genenadela/CET4811_MobileRobotArm/parts/readme.md

Parts were created in Fusion360.
Printed using Prusa Mk3, using PLA+.

Gripper and Arm design taken from howtomechatronics.com.
