genenadela/CET4811_MobileRobotArm/parts/gear1.STL

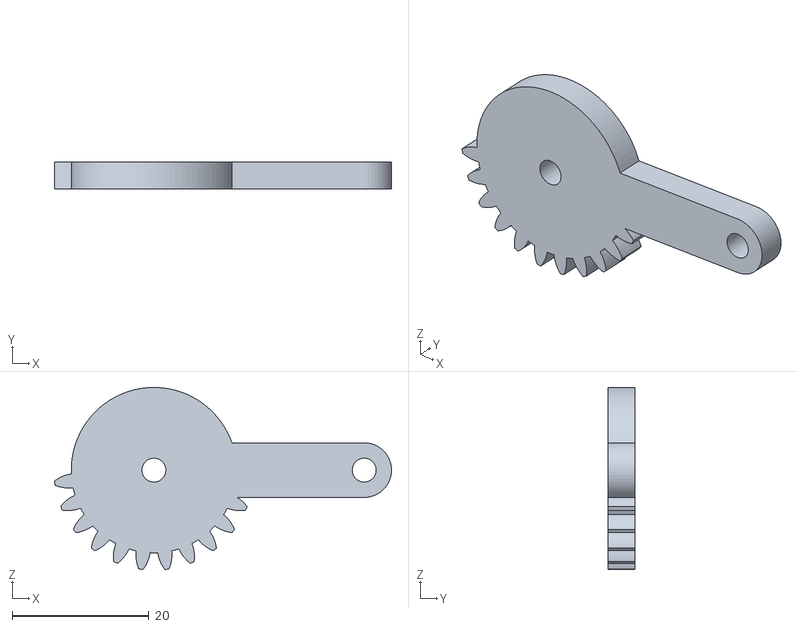
[picture p17: CAD file, 2020-10-12]
parts/gear1.STL
49.3 x 4.00 x 26.6
