genenadela/CET4811_MobileRobotArm/parts/studentmadeparts/autonomousrobot/axle1.stl

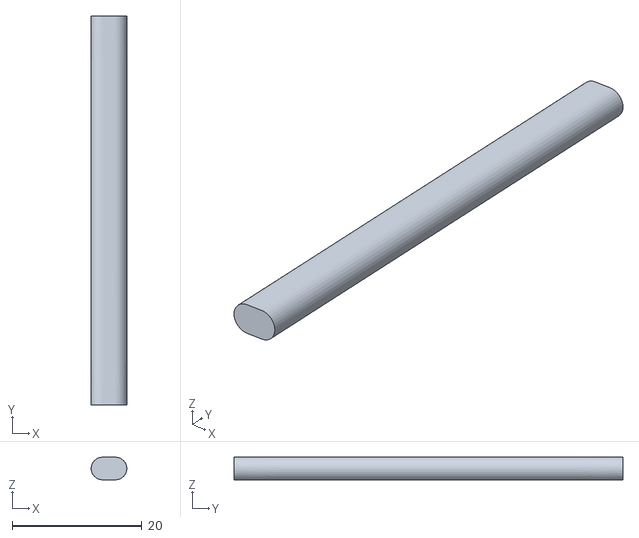
[picture p18: CAD file, 2020-10-12]
parts/studentmadeparts/autonomousrobot/axle1.stl
5.50 x 60.0 x 3.50
