genenadela/CET4811_MobileRobotArm/parts/studentmadeparts/frontcoverplate2.stl

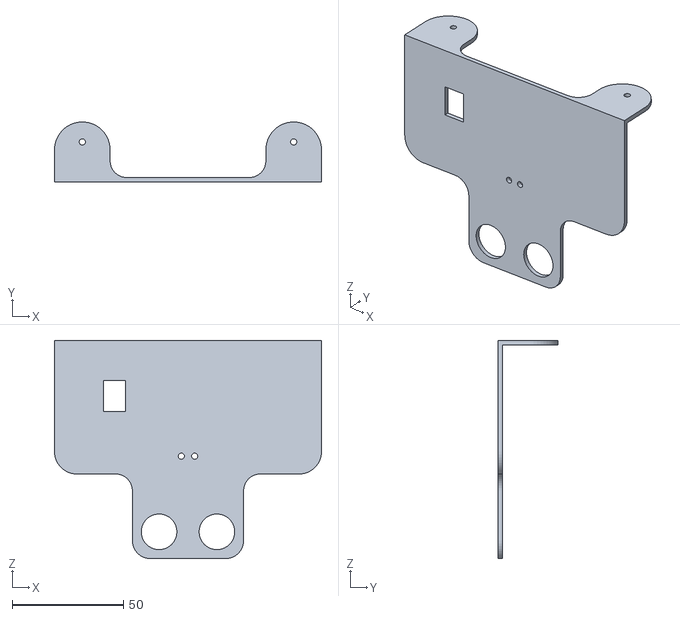
[picture p19: CAD file, 2020-10-12]
parts/studentmadeparts/frontcoverplate2.stl
120.0 x 27.0 x 98.0
