genenadela/CET4811_MobileRobotArm/parts/Arm 01.STL

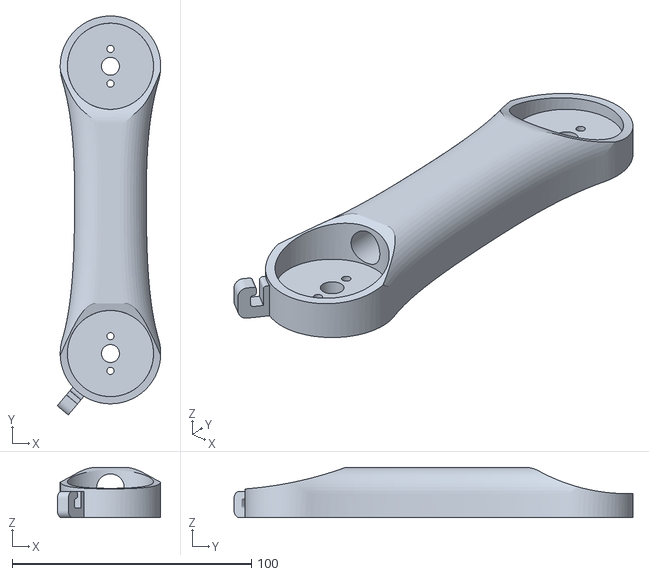
[picture p20: CAD file, 2020-10-12]
parts/Arm 01.STL
43.2 x 166.7 x 21.0
