genenadela/CET4811_MobileRobotArm/parts/studentmadeparts/WheelCoupler_DCMotorAdapter v3.stl

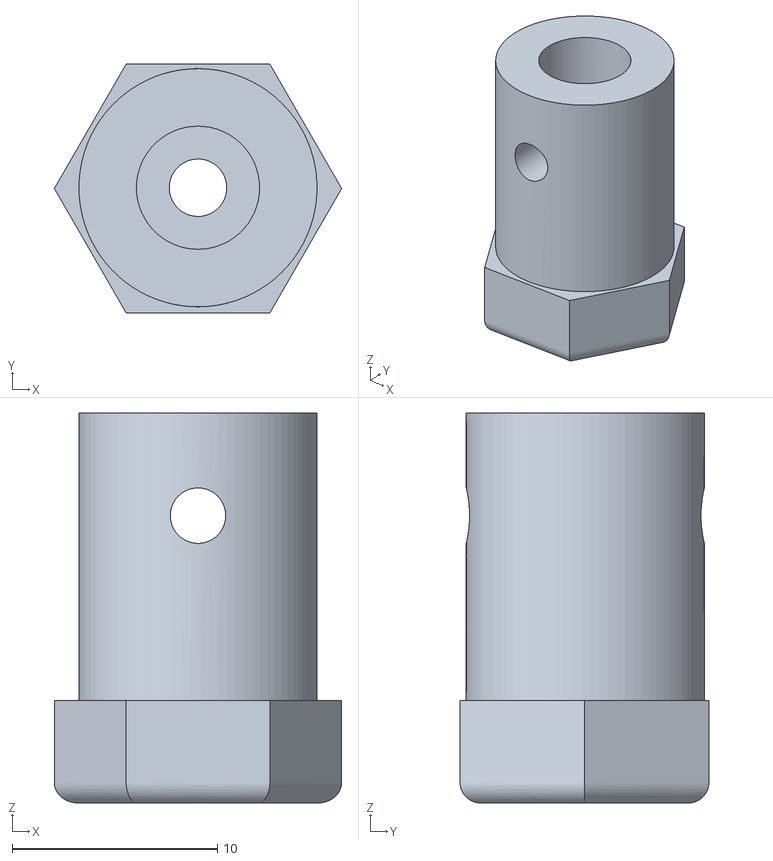
[picture p21: CAD file, 2020-10-12]
parts/studentmadeparts/WheelCoupler_DCMotorAdapter v3.stl
14.0 x 12.1 x 19.0
