genenadela/CET4811_MobileRobotArm/parts/studentmadeparts/wheelcoupler_dcmotor_v5.stl

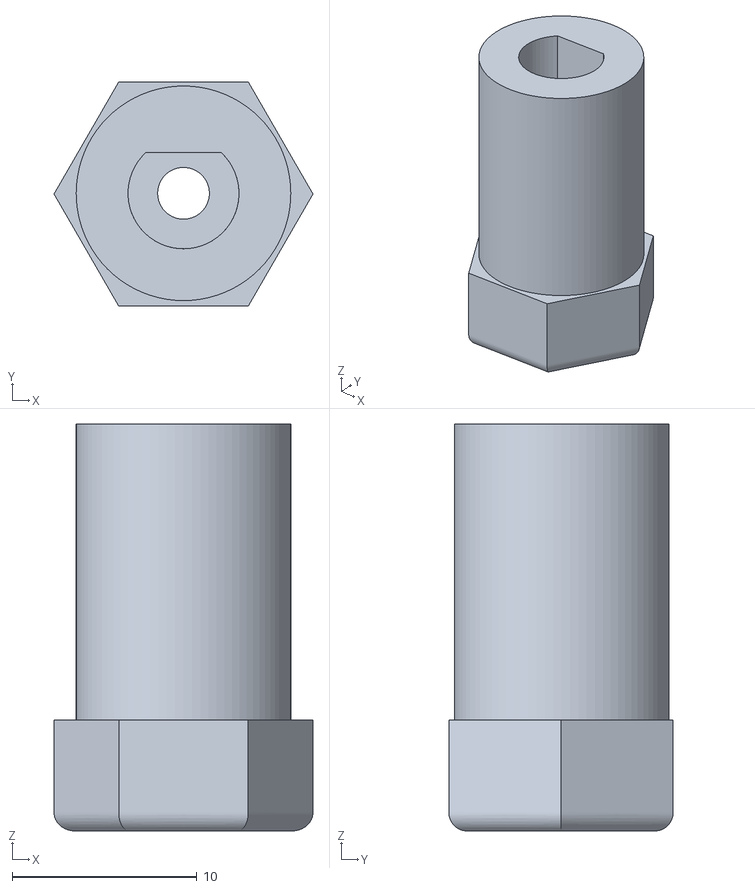
[picture p22: CAD file, 2020-10-12]
parts/studentmadeparts/wheelcoupler_dcmotor_v5.stl
14.0 x 12.1 x 22.0
