genenadela/CET4811_MobileRobotArm/parts/grip link 1.STL

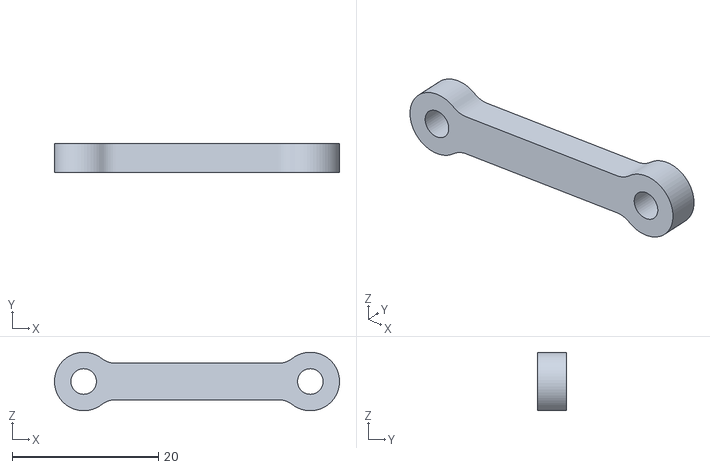
[picture p23: CAD file, 2020-10-12]
parts/grip link 1.STL
39.0 x 4.00 x 8.00
