genenadela/CET4811_MobileRobotArm/parts/studentmadeparts/BasePlatform v2.stl

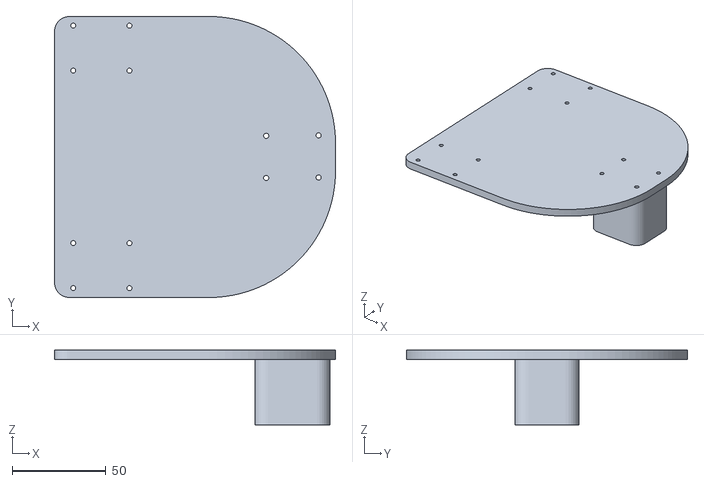
[picture p24: CAD file, 2020-10-12]
parts/studentmadeparts/BasePlatform v2.stl
150.0 x 150.0 x 40.0
