genenadela/CET4811_MobileRobotArm/parts/Gripper base.STL

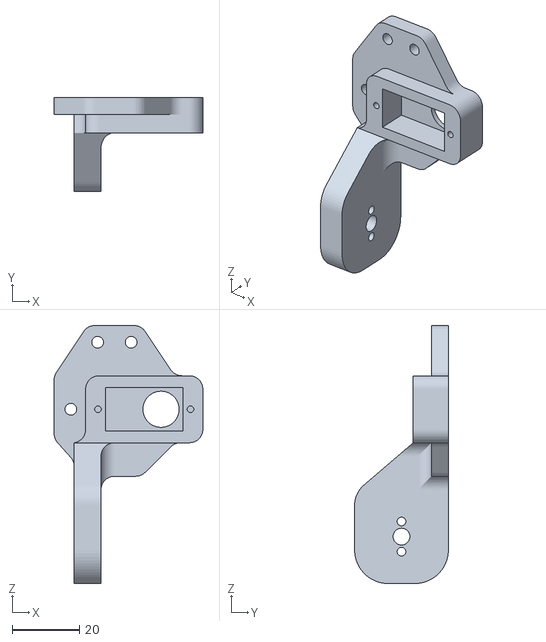
[picture p25: CAD file, 2020-10-12]
parts/Gripper base.STL
44.4 x 28.0 x 77.0
