genenadela/CET4811_MobileRobotArm/parts/studentmadeparts/upperplatform2.stl

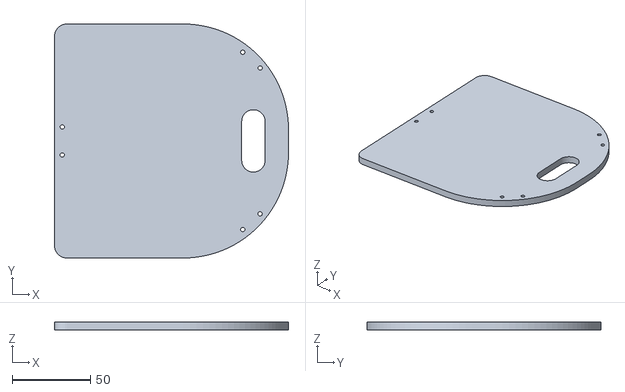
[picture p26: CAD file, 2020-10-12]
parts/studentmadeparts/upperplatform2.stl
150.0 x 150.0 x 5.00
