genenadela/CET4811_MobileRobotArm/parts/Arm 02 v3.STL

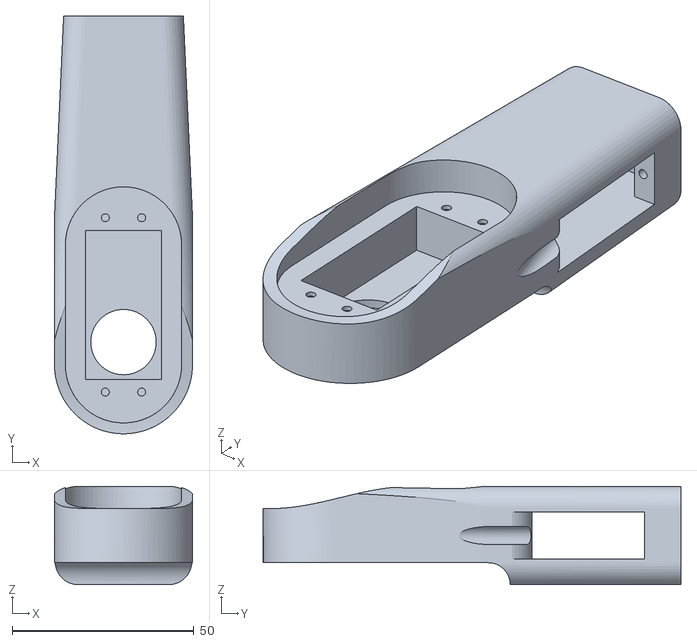
[picture p27: CAD file, 2020-10-12]
parts/Arm 02 v3.STL
38.0 x 115.0 x 27.0
