genenadela/CET4811_MobileRobotArm/parts/set2.3mf

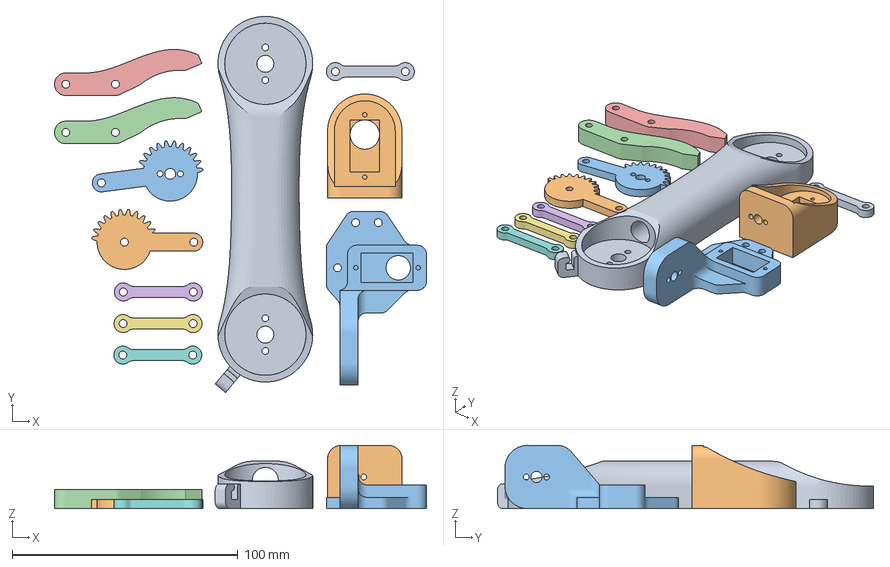
[picture p28: CAD file, 2020-10-12]
parts/set2.3mf
164.8 x 166.7 x 28.0 mm
Arm 01.STL
Arm 03.STL
Gripper base.STL
Gripper 1.STL
grip link 1.STL
gear1.STL
gear2.STL
