genenadela/CET4811_MobileRobotArm/parts/studentmadeparts/batteryholder.stl

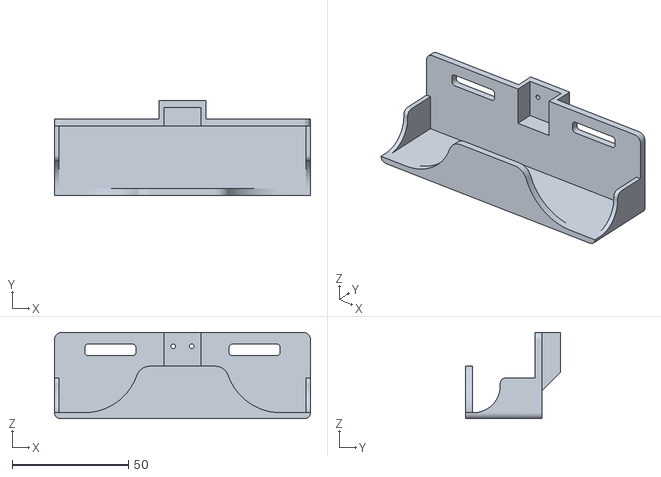
[picture p29: CAD file, 2020-10-12]
parts/studentmadeparts/batteryholder.stl
110.0 x 41.0 x 37.0
