genenadela/CET4811_MobileRobotArm/parts/Waist.STL

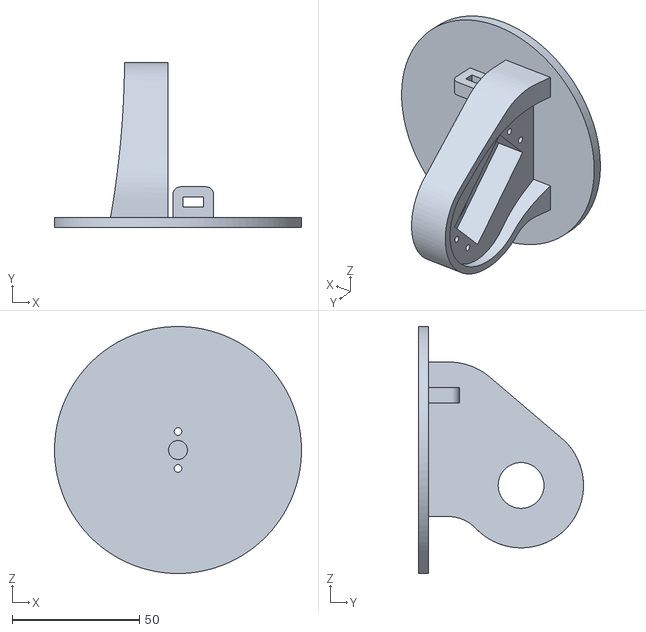
[picture p30: CAD file, 2020-10-12]
parts/Waist.STL
97.0 x 64.8 x 97.0
