genenadela/CET4811_MobileRobotArm/parts/Arm 03.STL

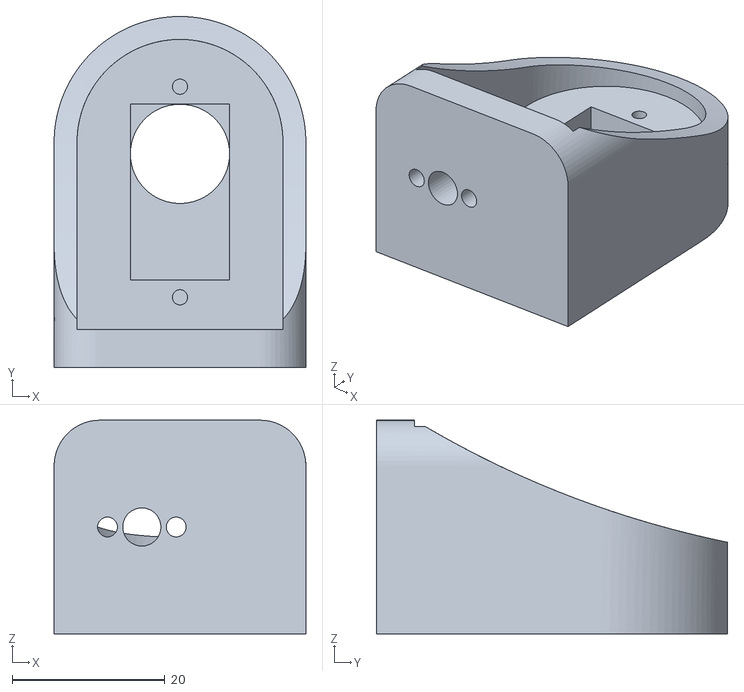
[picture p31: CAD file, 2020-10-12]
parts/Arm 03.STL
33.0 x 46.0 x 28.0
