genenadela/CET4811_MobileRobotArm/parts/Base.STL

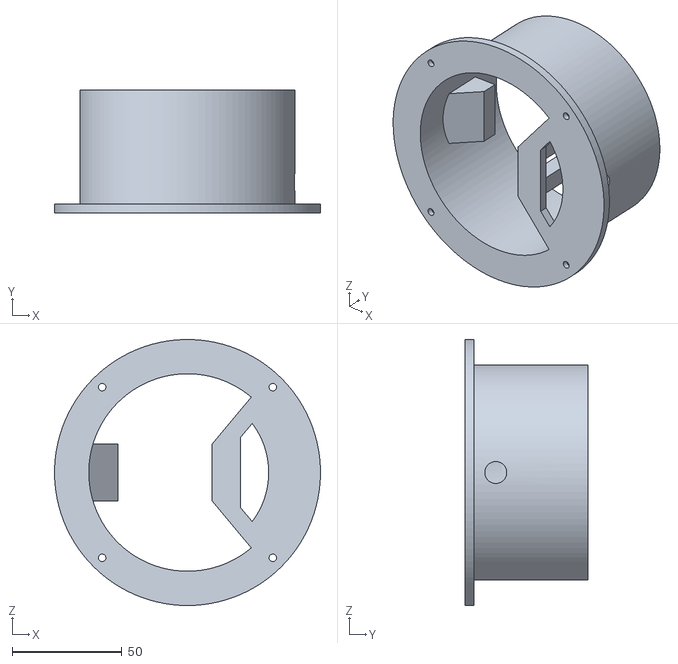
[picture p32: CAD file, 2020-10-12]
parts/Base.STL
121.2 x 56.0 x 121.2
