genenadela/CET4811_MobileRobotArm/parts/Gripper 1.STL

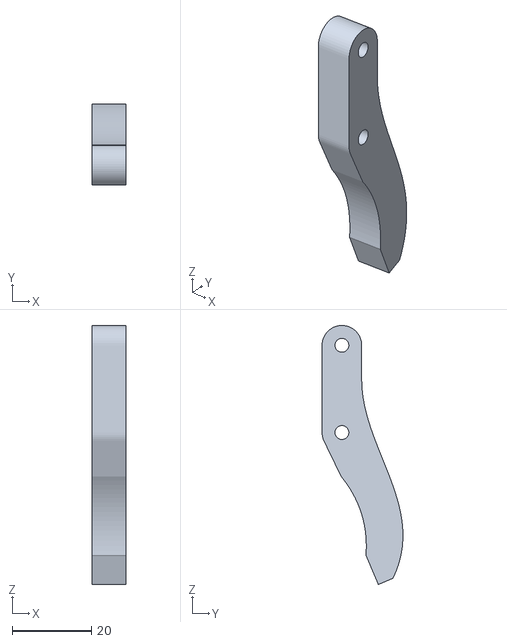
[picture p33: CAD file, 2020-10-12]
parts/Gripper 1.STL
8.50 x 20.4 x 65.3
