genenadela/CET4811_MobileRobotArm/(list of files, cad)

Other CAD files:
parts/gear2.STL
