genenadela/CET4811_MobileRobotArm/(list of files, drawings)

Other design files:
AutonmousMobileRobot1.fzz
